ankitmcgill/ESP2_MESSAGE_DISPLAY/pics/IMG_20190922_140111.jpg

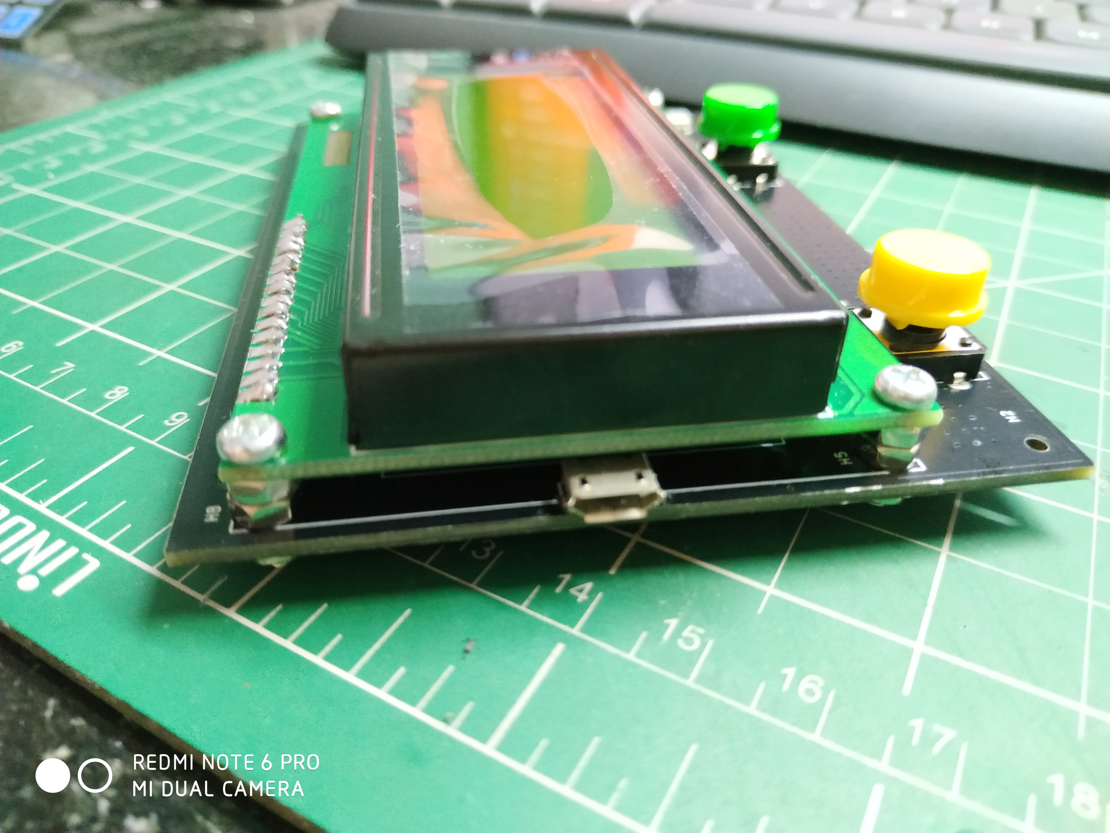
pics/IMG_20190922_140111.jpg
