ankitmcgill/ESP2_MESSAGE_DISPLAY/pics/IMG_20190922_115334.jpg

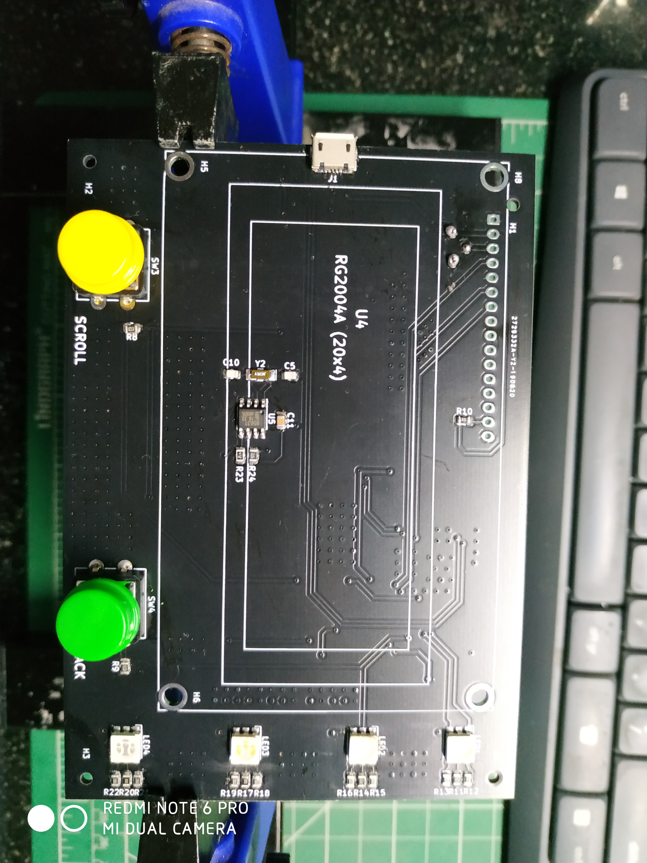
pics/IMG_20190922_115334.jpg
