ankitmcgill/ESP2_MESSAGE_DISPLAY/README.md

# ESP2_MESSAGE_DISPLAY
ESP32 Based Message Display System
