ankitmcgill/ESP2_MESSAGE_DISPLAY/pics/IMG_20190922_115444.jpg

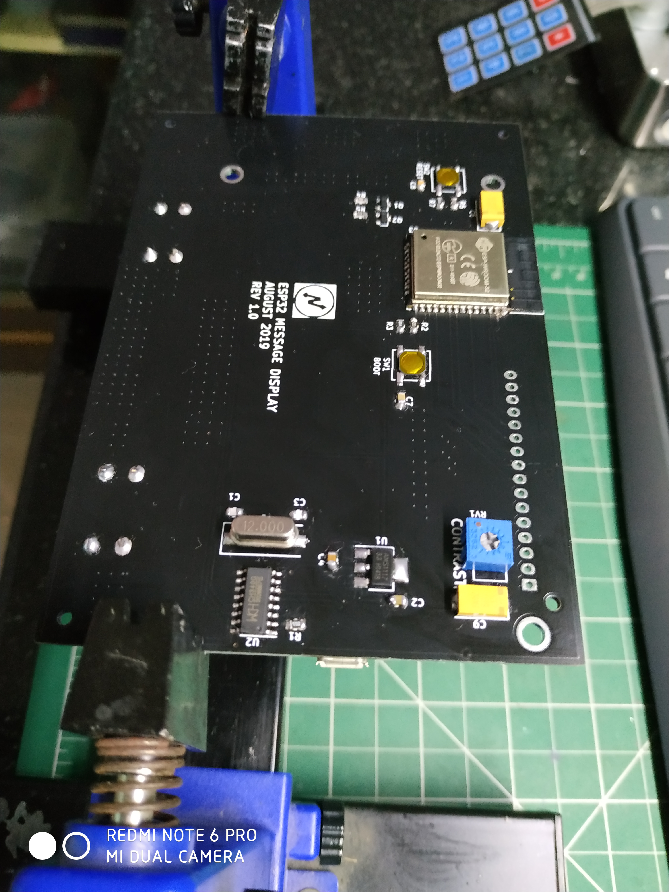
pics/IMG_20190922_115444.jpg
