ankitmcgill/ESP2_MESSAGE_DISPLAY/pics/IMG_20190924_223317.jpg

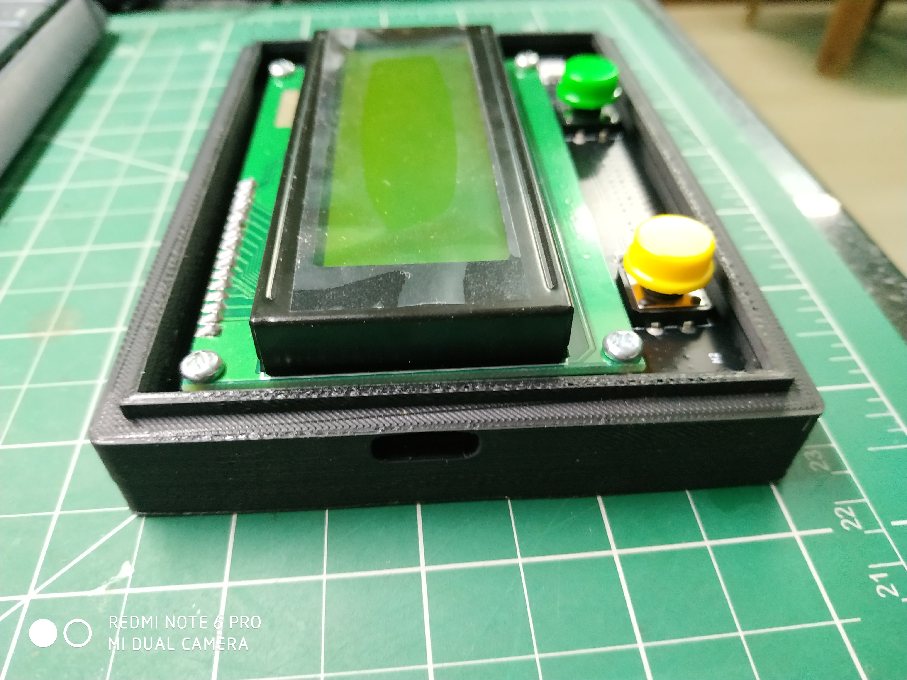
pics/IMG_20190924_223317.jpg
