ankitmcgill/ESP2_MESSAGE_DISPLAY/pics/IMG_20190924_223331.jpg

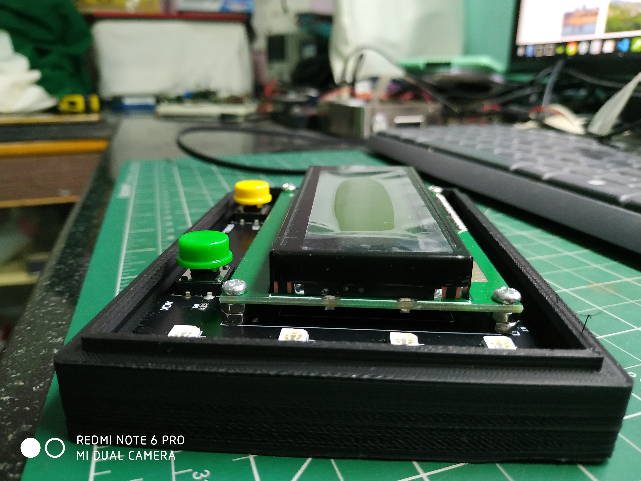
pics/IMG_20190924_223331.jpg
