ankitmcgill/ESP2_MESSAGE_DISPLAY/board/EXPORTS/bom/bom.xlsx

# | References | Value | Footprint | Quantity
1 | C1, C3 | 22PF | C_0805_2012Metric | 2
2 | C11 | 100NF | C_0805_2012Metric | 1
3 | C2 | 10UF | C_0805_2012Metric | 1
4 | C4 | 1UF | C_0805_2012Metric | 1
5 | C5, C10 | 12.5PF | C_0805_2012Metric | 2
6 | C6, C9 | 330UF | CP_EIA-7343-31_Kemet-D | 2
7 | C7, C8 | 1NF | C_0805_2012Metric | 2
8 | G*** | LOGO | nomadic_controls_10mm | 1
9 | J1 | USB_B_Micro | USB_Micro-B_Molex_47346-0001 | 1
10 | LED1, LED2, LED3, LED4 | RGBLED5050 | LED_RGB_5050-6 | 4
11 | Q1, Q2 | MMBT5551 | SOT-23 | 2
12 | R1, R3, R7 | 470 | R_0805_2012Metric | 3
13 | R10, R11, R14, R17, R20 | 330 | R_0805_2012Metric | 5
14 | R12, R13, R15, R16, R18, R19, R21, R22 | 220 | R_0805_2012Metric | 8
15 | R2, R4, R5, R6, R8, R9 | 10K | R_0805_2012Metric | 6
16 | R23, R24 | 4.7K | R_0805_2012Metric | 2
17 | RV1 | 10K | Potentiometer_Bourns_3386X_Horizontal | 1
18 | SW1, SW2 | SW_Push | SW_SPST_B3SL-1022P | 2
19 | SW3, SW4 | SW_Push | SW_PUSH-12mm_Wuerth-430476085716 | 2
20 | U1 | AMS1117-3.3 | SOT-223-3_TabPin2 | 1
21 | U2 | CH340G | SOIC-16_3.9x9.9mm_P1.27mm | 1
22 | U3 | ESP32-WROOM-32 | ESP32-WROOM-32 | 1
23 | U4 | RG2004A (20x4) | LCD_4lin | 1
24 | U5 | PCF8563T | SOIC-8_3.9x4.9mm_P1.27mm | 1
25 | Y1 | 12MHZ | Crystal_SMD_HC49-SD | 1
26 | Y2 | 32.768KHZ | Crystal_SMD_MicroCrystal_CC7V-T1A-2Pin_3.2x1.5mm_HandSoldering | 1
