ankitmcgill/ESP2_MESSAGE_DISPLAY/board/EXPORTS/SCHEMATIC.pdf

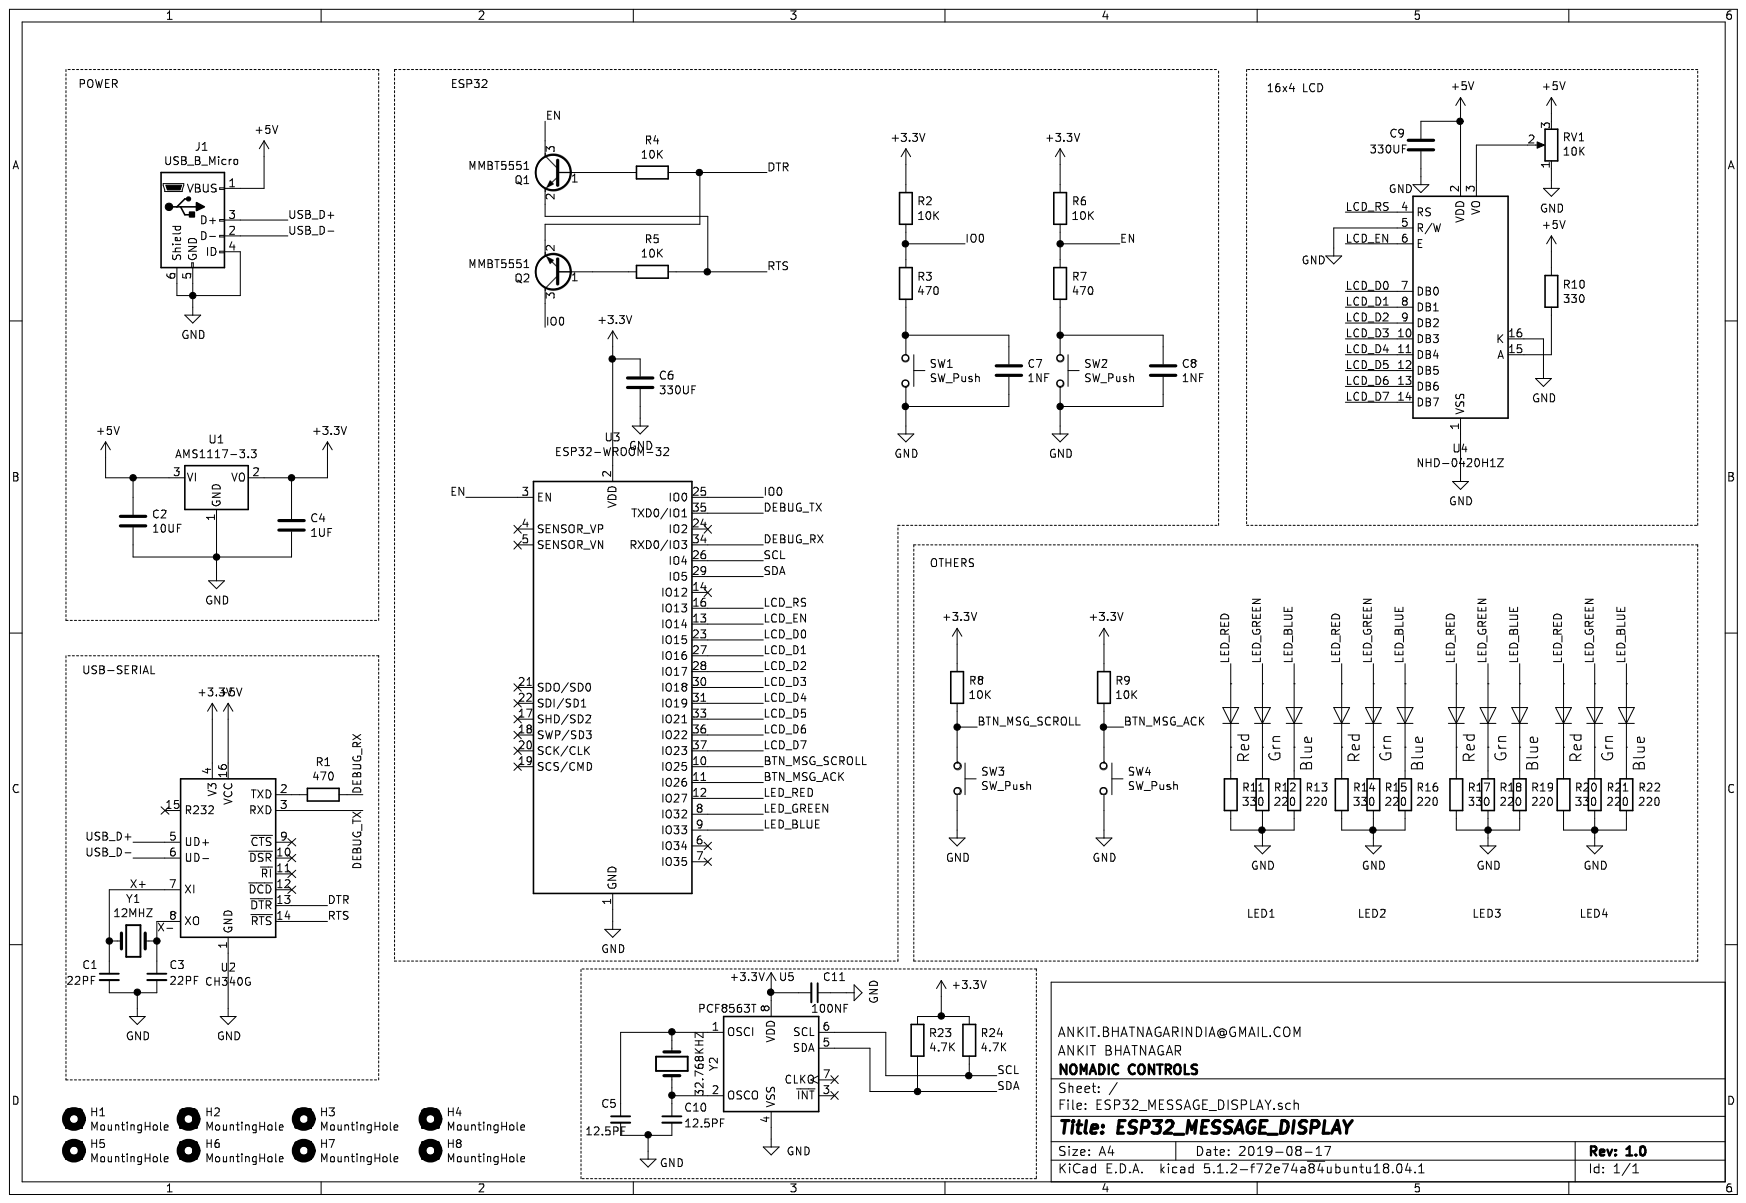
[picture p7: page 1]
