ankitmcgill/ESP2_MESSAGE_DISPLAY/board/ESP32_MESSAGE_DISPLAY.kicad_pcb

## KiCad design board/ESP32_MESSAGE_DISPLAY.kicad_pcb (2019-11-02)

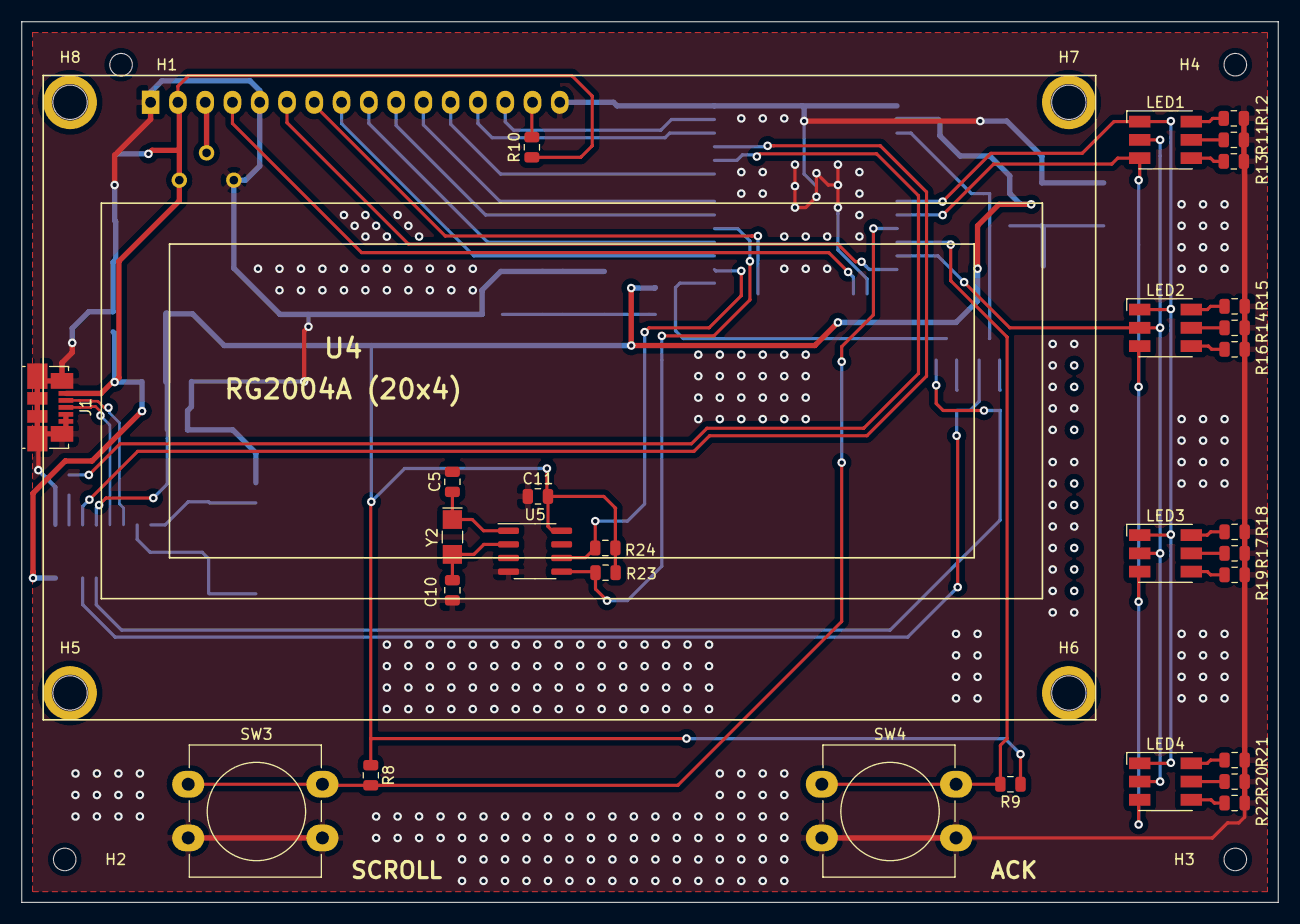
[picture p8: board ESP32_MESSAGE_DISPLAY.kicad_pcb from above]

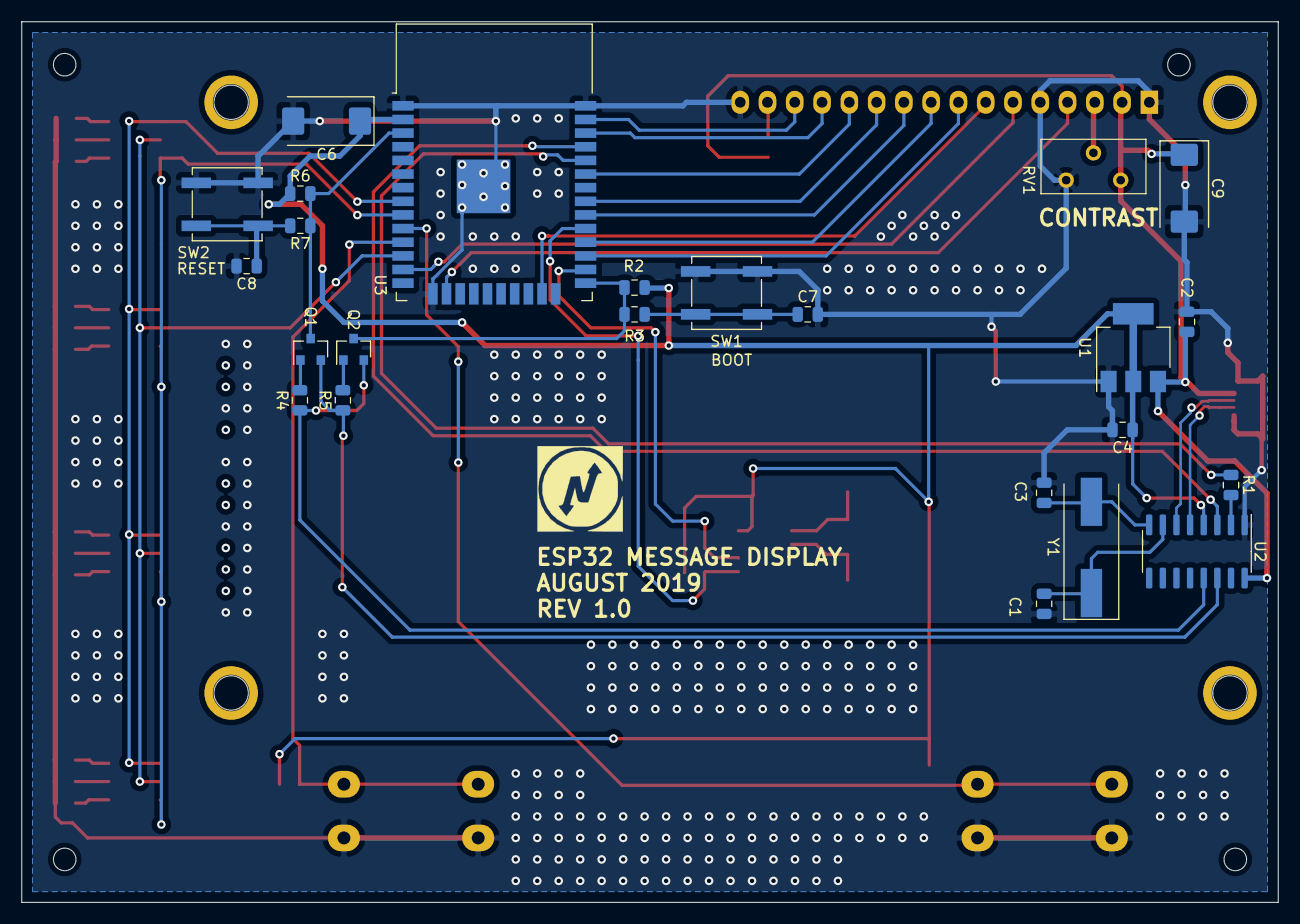
[picture p9: board ESP32_MESSAGE_DISPLAY.kicad_pcb from below]

Board: 2 copper layers, 117.0 x 82.0 mm, 62 parts (24 on the bottom side), 51 nets.

Parts:
C1, C3: 22PF; C_0805_2012Metric
C2: 10UF; C_0805_2012Metric
C4: 1UF; C_0805_2012Metric
C5, C10: 12.5PF; C_0805_2012Metric
C6, C9: 330UF; CP_EIA-7343-31_Kemet-D
C7, C8: 1NF; C_0805_2012Metric
C11: 100NF; C_0805_2012Metric
H1, H2, H3, H4: MountingHole; MountingHole_2.1mm
H5, H6, H7, H8: MountingHole; MountingHole_3.2mm_M3
J1: USB_B_Micro; USB_Micro-B_Molex_47346-0001
LED1, LED2, LED3, LED4: RGBLED5050; LED_RGB_5050-6
Q1, Q2: MMBT5551; SOT-23
R1, R3, R7: 470; R_0805_2012Metric
R2, R4, R5, R6, R8, R9: 10K; R_0805_2012Metric
R10, R11, R14, R17, R20: 330; R_0805_2012Metric
R12, R13, R15, R16, R18, R19, R21, R22: 220; R_0805_2012Metric
R23, R24: 4.7K; R_0805_2012Metric
RV1: 10K; Potentiometer_Bourns_3386X_Horizontal
SW1, SW2: SW_Push; SW_SPST_B3SL-1022P
SW3, SW4: SW_Push; SW_PUSH-12mm_Wuerth-430476085716
U1: AMS1117-3.3; SOT-223-3_TabPin2
U2: CH340G; SOIC-16_3.9x9.9mm_P1.27mm
U3: ESP32-WROOM-32
U4: RG2004A (20x4); LCD_4lin
U5: PCF8563T; SOIC-8_3.9x4.9mm_P1.27mm
Y1: 12MHZ; Crystal_SMD_HC49-SD
Y2: 32.768KHZ; Crystal_SMD_MicroCrystal_CC7V-T1A-2Pin_3.2x1.5mm_HandSolder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

Connections:
+3V3: C4.1, C6.1, C11.2, R2.1, R6.1, R8.1, R9.1, R23.1, R24.1, U1.2, U2.4, U3.2, U5.8
+5V: C2.1, C9.1, J1.1, R10.1, RV1.3, U1.3, U2.16, U4.2
/BTN_MSG_ACK: R9.2, SW4.1, U3.11
/BTN_MSG_SCROLL: R8.2, SW3.1, U3.10
/DEBUG_RX: R1.1, U3.34
/DEBUG_TX: U2.3, U3.35
/DTR: Q2.2, R4.1, U2.13
/EN: Q1.3, R6.2, R7.1, U3.3
/IO0: Q2.3, R2.2, R3.1, U3.25
/LCD_D0: U3.23, U4.7
/LCD_D1: U3.27, U4.8
/LCD_D2: U3.28, U4.9
/LCD_D3: U3.30, U4.10
/LCD_D4: U3.31, U4.11
/LCD_D5: U3.33, U4.12
/LCD_D6: U3.36, U4.13
/LCD_D7: U3.37, U4.14
/LCD_EN: U3.13, U4.6
/LCD_RS: U3.16, U4.4
/LED_BLUE: LED1.3, LED2.3, LED3.3, LED4.3, U3.9
/LED_GREEN: LED1.1, LED2.1, LED3.1, LED4.1, U3.8
/LED_RED: LED1.2, LED2.2, LED3.2, LED4.2, U3.12
/RTS: Q1.2, R5.1, U2.14
/SCL: R24.2, U3.26, U5.6
/SDA: R23.2, U3.29, U5.5
/USB_D+: J1.3, U2.5
/USB_D-: J1.2, U2.6
/X+: C1.1, U2.7, Y1.1
/X-: C3.1, U2.8, Y1.2
GND: C1.2, C2.2, C3.2, C4.2, C5.2, C6.2, C7.2, C8.2, C9.2, C10.2, C11.1, J1.4, J1.5, J1.6, R11.2, R12.2, R13.2, R14.2, R15.2, R16.2, R17.2, R18.2, R19.2, R20.2, R21.2, R22.2, RV1.1, SW1.2, SW2.2, SW3.2, SW4.2, U1.1, U2.1, U3.1, U3.15, U3.38, U4.1, U4.5, U4.16, U5.4
unnamed: C5.1, U5.1, Y2.1
unnamed: C7.1, R3.2, SW1.1
unnamed: C8.1, R7.2, SW2.1
unnamed: C10.1, U5.2, Y2.2
unnamed: LED1.4, R13.1
unnamed: LED1.5, R11.1
unnamed: LED1.6, R12.1
unnamed: LED2.4, R16.1
unnamed: LED2.5, R14.1
unnamed: LED2.6, R15.1
unnamed: LED3.4, R19.1
unnamed: LED3.5, R17.1
unnamed: LED3.6, R18.1
unnamed: LED4.4, R22.1
unnamed: LED4.5, R20.1
unnamed: LED4.6, R21.1
unnamed: Q1.1, R4.2
unnamed: Q2.1, R5.2
unnamed: R1.2, U2.2
unnamed: R10.2, U4.15
unnamed: RV1.2, U4.3
