ankitmcgill/ESP2_MESSAGE_DISPLAY/src/components/bsp/bsp.h

///////////////////////////////////////////////////////////////
//ESP32 MESSAGE DISPLAY
//
//BOARD SUPPORT PACKAGE
//(PIN MAPPINGS)
//

//NOVEMBER 2 2019
///////////////////////////////////////////////////////////////

#ifndef _BSP_
#define _BSP_

#define BSP_LED_RED                 (27)
#define BSP_LED_GREEN               (33)
#define BSP_LED_BLUE                (32)

#define BSP_BUTTON_SCROLL           (25)
#define BSP_BUTTON_ACK              (26)

#define BSP_I2C_SCL                 (4)
#define BSP_I2C_SDA                 (5)

#define BSP_LCD_RS                  (13)
#define BSP_LCD_EN                  (14)
#define BSP_LCD_D0                  (15)
#define BSP_LCD_D1                  (16)
#define BSP_LCD_D2                  (17)
#define BSP_LCD_D3                  (18)
#define BSP_LCD_D4                  (19)
#define BSP_LCD_D5                  (21)
#define BSP_LCD_D6                  (22)
#define BSP_LCD_D7                  (23)

#endif
