ankitmcgill/ESP2_MESSAGE_DISPLAY/src/main/default_provisioning.h

#ifndef _DEFAULT_PROVISIONING_
#define _DEFAULT_PROVISIONING_

#include "project_info.h"

//Regular Wifi / Server Configuration
#define DEFUALT_WIRELESS_SSID           "ankit"
#define DEFUALT_WIRELESS_PASSWORD       "casa2016"

#define DEFUALT_SERVER_PORT             "8888"

#endif
