ankitmcgill/ESP2_MESSAGE_DISPLAY/src/main/project_info.h

#ifndef _PROJECT_INFO_
#define _PROJECT_INFO_

#define PROJECT_NAME        "ESP32 MESSAGE DISPLAY"
#define PROJECT_DATE        "NOVEMBER 2 2019"

#define GIT_BRANCH          ""
#define GIT_COMMIT          ""

#endif
