ankitmcgill/ESP2_MESSAGE_DISPLAY/(commit log)

2019-11-02 initial board files and pictures
    [ESP32_MESSAGE_DISPLAY-B_Cu.gbr, ESP32_MESSAGE_DISPLAY-B_Mask.gbr, ESP32_MESSAGE_DISPLAY-B_Paste.gbr, ESP32_MESSAGE_DISPLAY-B_SilkS.gbr, ESP32_MESSAGE_DISPLAY-Edge_Cuts.gbr, ESP32_MESSAGE_DISPLAY-F_Cu.gbr, ESP32_MESSAGE_DISPLAY-F_Mask.gbr, ESP32_MESSAGE_DISPLAY-F_Paste.gbr]
2019-11-04 added basic led, lcd and button code
2019-11-05 added right justified string print function in lcd
2019-11-12 added 1 mb media partition
    [partitions.csv]
